pong74ls/Nibbler/README.md

This project is based on an original design by Steve Chamberlin.

For information on how Nibbler works, development history, demonstrations and software downloads, go to:

http://www.bigmessowires.com/nibbler/
