pong74ls/Nibbler/Enclosure/Nibbler - Button Extension.stl

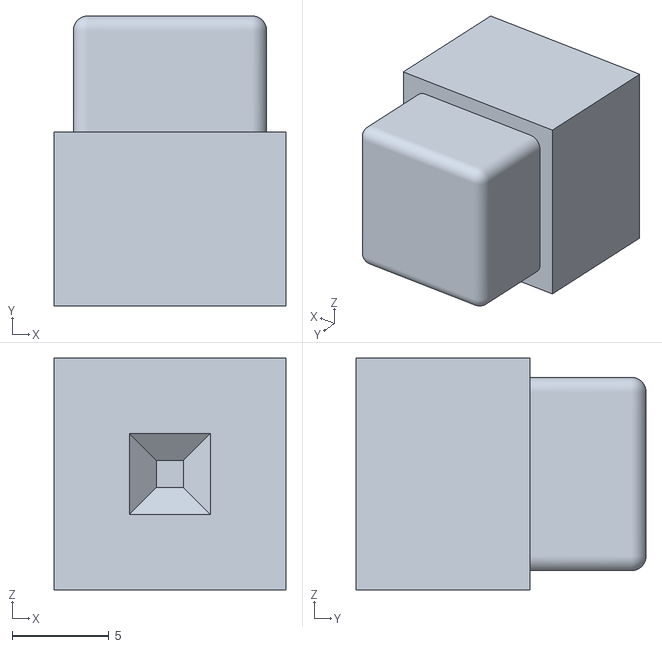
[picture p1: CAD file, 2016-07-01]
Enclosure/Nibbler - Button Extension.stl
12.0 x 15.0 x 12.0
