pong74ls/Nibbler/Enclosure/Nibbler - Case.dxf

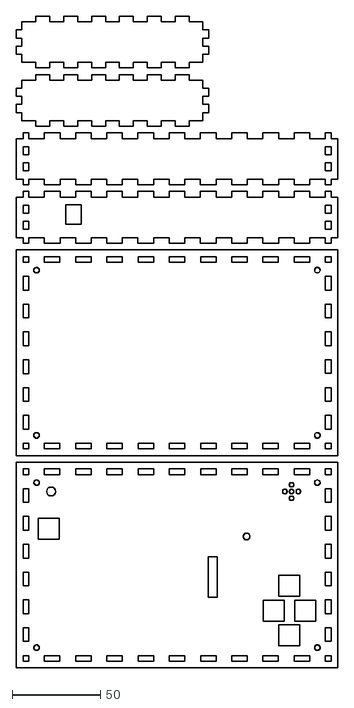
[picture p2: CAD file, 2016-07-01]
Enclosure/Nibbler - Case.dxf
181.6 x 368.4
