pong74ls/Nibbler/(list of files, cad)

Other CAD files:
Enclosure/Nibbler - Button Extension.f3d
