pong74ls/Nibbler/Documentation/Nibbler - Schematic.pdf

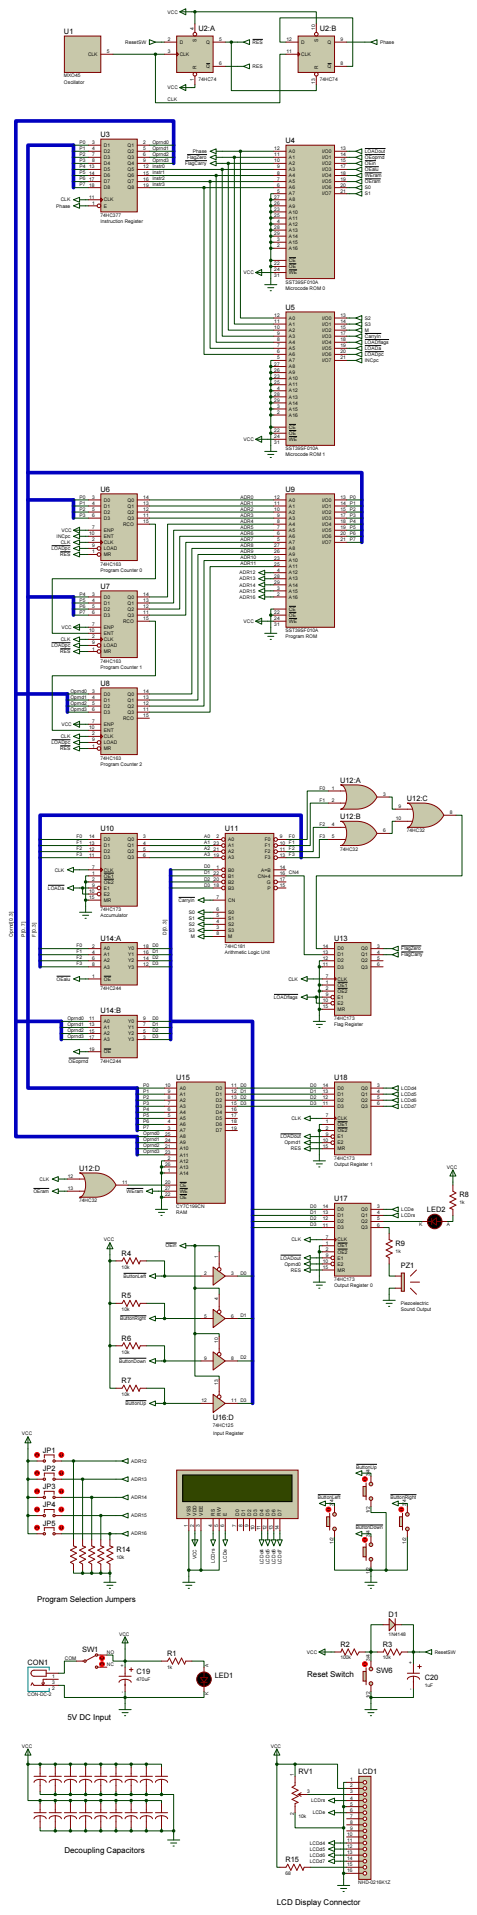
[picture p3: page 1]
