pong74ls/Nibbler/(list of files, drawings)

Other design files:
Schematics - Proteus Design Suite/Buttons.pdsprj
Schematics - Proteus Design Suite/Nibbler.pdsprj
