pong74ls/Nibbler/(commit log)

2016-04-24 Nibbler - Design Files and Documentation
    [Buttons.pdsprj, Nibbler.pdsprj]
2016-07-01 Added files for laser cut enclosure
    [Nibbler - Button Extension.f3d, Nibbler - Button Extension.stl, Nibbler - Case.dxf]
